LU-Centre-for-Autonomous-Systems/3-DoF-endEffector/README.md

this git includes all the CAD models and the arduino codes implemented on Ben's drone to interact with the environment
