LU-Centre-for-Autonomous-Systems/3-DoF-endEffector/rangeSensorReadArd/README

This is the code for the Range Finder sensor (PSK-CM8JL65-CC5). It was not used since the sensor was inaccurate and had a drift over time that was not ideal.
