LU-Centre-for-Autonomous-Systems/3-DoF-endEffector/Talent-match poster-v2.pdf

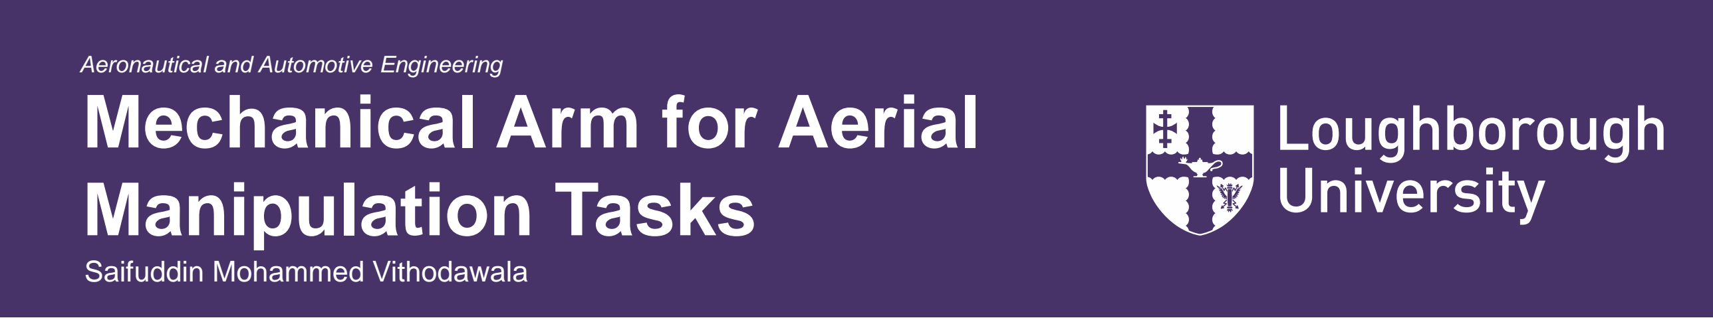
[picture p1: figure]
Saifuddin Mohammed Vithodawala; Aeronautical and Automotive Engineering Mechanical Arm for Aerial Manipulation Tasks

REFERENCES
1. Daniel Smrcka, Tomas Baca, Tiago Nascimento, Martin Saska, ‘Admittance Force-Based UAV-Wall Stabilization and Press Exertion for
Documentation and Inspection of Historical Buildings’, IEEE
2. Anibal Ollero, Marco Tognon, Alejandro Suarez,

Dongjun Lee, Antonio Franchi, ‘Past, Present, and Future of Aerial Robotic MAnipulators’, IEEE

ACKNOWLEDGEMENTS
Huge thanks to Ben Marshall and James Knowles for giving me this opportunity and their guidance throughout the internship. A special thanks to the entire Loughborough University Centre for Autonomous Systems lab for their assistance especially during the installation and setup of ROS2.

CONTACT INFORMATION
Department of Aeronautical and Automotive Engineering
Loughborough University
Leicestershire LE11 3TU UK S.Mohammed-Vithodawala-22@student.lboro.ac.uk www.lboro.ac.uk/department/aae

### Introduction

Aerial manipulation using robotic arms is a growing area of research with applications in search and rescue, surveillance, and precision tasks. This project focuses on the development of a robust 3-degree-of-freedom (DOF) end effector, designed to perform complex movements while maintaining stability in aerial environments. Additionally, a sensor was calibrated and integrated to measure the arm’s deflection, ensuring precise control and feedback during manipulation. This research aims to enhance the efficiency and accuracy of aerial robotic systems, contributing to advancements in aerial manipulation technologies.

### 1.Design of the Aerial Manipulator:

- The 3-degree-of-freedom end effector, utilizing a ball-and-socket joint mechanism, was designed for flexibility and precision in aerial manipulation.
- The self-contained design integrates a sensor and an end effector into a compact unit, simplifying operation without external systems which also makes it easy to integrate with any aerial system.
- The end effector was fabricated using 3D printing to create the ball-and-socket joint and other components. A "print-in-place" method was used to ensure the entire joint was printed as a single unit, avoiding the need for post-print assembly and complex fitting while maintaining tight tolerances.

Render of the CAD model of the ball and socket joint, purple – socket, green – ball + end plate

### 2.Sensor Calibration and Deflection Measurement:

- A time-of-flight sensor is integrated into the end effector to measure deflection during movement. This deflection is then converted to a force using F = kΔx.
- The calibration process began with manually measuring deflection distances using a measuring tape. These measurements were then plotted in Excel against the sensor readings to generate a calibration curve. Using the formula derived from the trendline, the sensor was calibrated to ensure that its output accurately reflected the real-world deflections.
- To improve the stability and accuracy of the readings, an exponential filter was implemented in the Arduino code. This filter reduced the white noise present in the sensor data, resulting in smoother and more reliable outputs.
y = 0.9393x - 12.383 | | | | 274 246.4
R² = 0.9941 | | | 223.8 192.2
| | 168.6 154.4
| 129.8 108.6

0

50

100

150

200

250

300

0 | 50 | 100 | 150 | 200 | 250 | 300 | 350

Sensor Readings (mm)

Physical Measurements (mm)

Sensor Output
Graph of the sensor output and the filter output, orange – sensor output,
Sensor Calibration Curve | purple – filter output

### 3.Software Setup:

- The drone was set up with Ubuntu 20.04 server which is a Linux based operating software installed on a Raspberry Pi 3 B+.
- This enabled the installation of ROS2, uXRCE and additional packages that allows the drone to communicate with the VICON and the flight controller via network so that it can fly autonomously.

1
2

Companion PC

Sensor | Arduino | Vicon

3

Flight
Controller

Motor Speed
Controller

Serial
ROS2 topic
PWM signal

Flow Chart of the System

Conclusion
Summary:
- The development of a 3-degree-of-freedom end effector, utilizing a ball-and-socket joint, demonstrates a robust solution for aerial manipulation tasks.
- The integration of a calibrated sensor provides precise deflection measurements, ensuring accurate control and feedback.
- The end effector’s lightweight, self-contained design simplifies its integration into various aerial systems, enhancing its versatility.

Future Work Ideas:
Focus on refining the sensor system for real-time adjustments and expanding the design for more complex manipulation tasks in dynamic environments.
