LU-Centre-for-Autonomous-Systems/3-DoF-endEffector/(list of files, cad)

Other CAD files:
enfEffectorCAD/Assembly.prt
enfEffectorCAD/Ball.prt
enfEffectorCAD/End-Effector-Attachment-V2.prt
enfEffectorCAD/End-Effectot-Attachment-V2.prt
enfEffectorCAD/EndPlate-V1.5.prt
enfEffectorCAD/Hinge-v1.prt
enfEffectorCAD/RangeFinder Mount-clamp.prt
enfEffectorCAD/RangeFinder Mount.prt
enfEffectorCAD/Reflector.prt
enfEffectorCAD/Slider-Hook-V2.prt
enfEffectorCAD/Socket.prt
enfEffectorCAD/arm-assembly-v2.prt
enfEffectorCAD/chord.prt
enfEffectorCAD/end plate.prt
enfEffectorCAD/guide.prt
enfEffectorCAD/nanoHolder-V2.1.prt
enfEffectorCAD/nanoHolder-V2.prt
enfEffectorCAD/nanoHolder.prt
enfEffectorCAD/sensorMount-V2.prt
enfEffectorCAD/slider hook.prt
enfEffectorCAD/spar guider.prt
enfEffectorCAD/spar.prt
